dezash123/ring-pcb/models/BM03B-SRSS-TB.stp

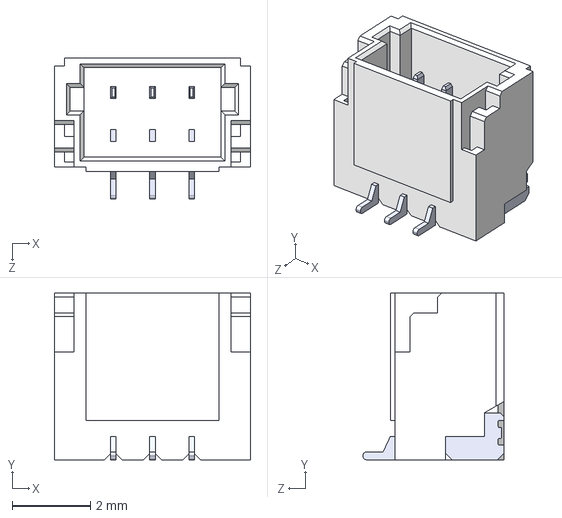
[picture p1: CAD file, 2025-11-14]
models/BM03B-SRSS-TB.stp
5.00 x 4.25 x 3.60 mm
