dezash123/ring-pcb/models/PG-LLGA-5-4_Z8B00190520_V03_3D.stp

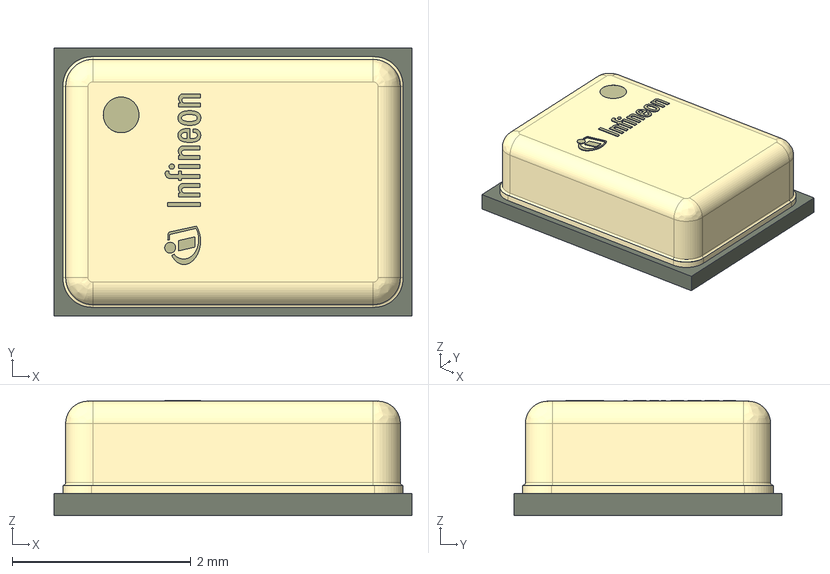
[picture p2: CAD file, 2025-11-14]
models/PG-LLGA-5-4_Z8B00190520_V03_3D.stp
4.00 x 3.00 x 1.29 mm
