dezash123/ring-pcb/models/DQN0004A.stp

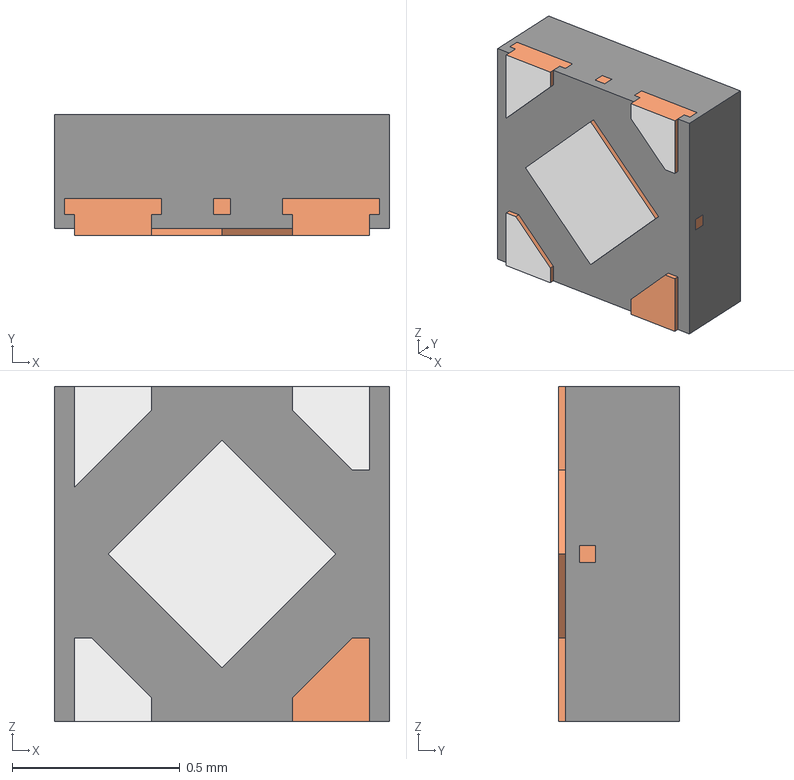
[picture p3: CAD file, 2025-11-14]
models/DQN0004A.stp
1.00 x 0.36 x 1.00 mm
MOLD-SNB04A
FRAME-SNB04A
