dezash123/ring-pcb/models/MAX30102EFD_T.stp

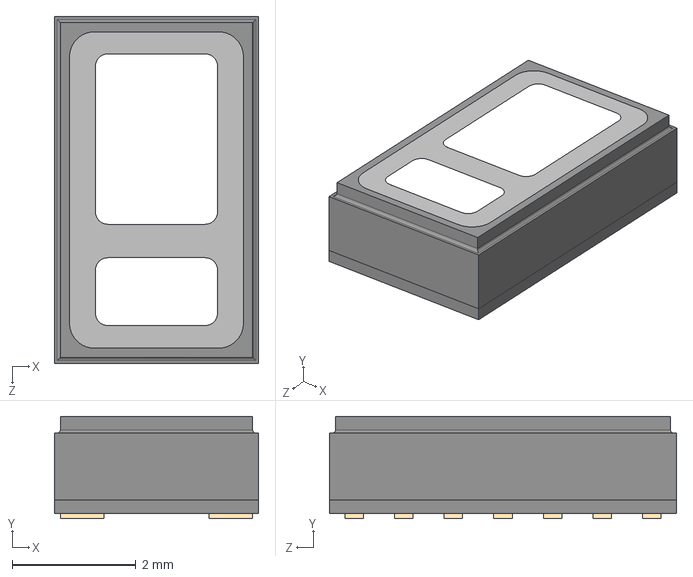
[picture p4: CAD file, 2025-11-14]
models/MAX30102EFD_T.stp
3.30 x 1.65 x 5.60 mm
