dezash123/ring-pcb/layout/layout-rounded.kicad_pcb

## KiCad design layout/layout-rounded.kicad_pcb (2025-10-16)

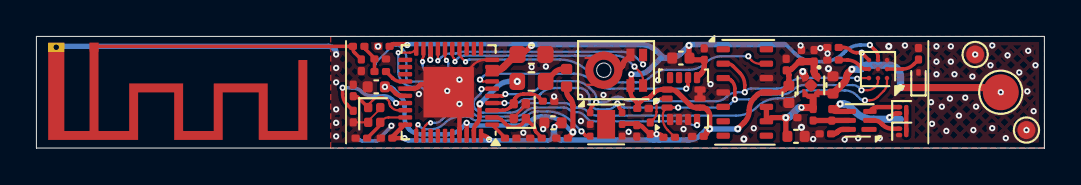
[picture p5: board layout-rounded.kicad_pcb from above]

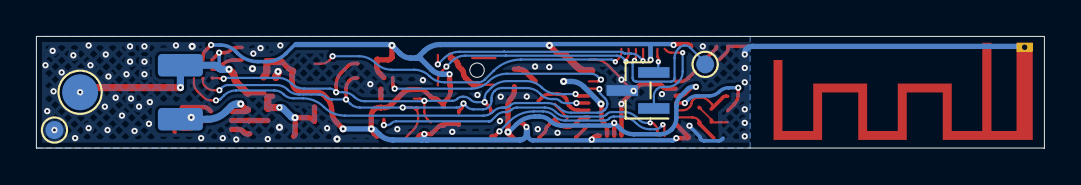
[picture p6: board layout-rounded.kicad_pcb from below]

Board: 2 copper layers, 56.0 x 6.2 mm, 60 parts (5 on the bottom side), 36 nets.

Parts:
BT1: ?; Battery
C1, C28, C29: 1uF; C_0201_0603Metric
C2: 2.2uF; C_0201_0603Metric
C3, C7, C8, C12, C19, C21, C22, C23, C25, C26: 100nF; C_0201_0603Metric
C4, C9: 5pF; C_0201_0603Metric
C5: 4.7uF; C_0603_1608Metric
C6, C14, C24, C27: 1uF; C_0402_1005Metric
C10, C11: 12pF; C_0201_0603Metric
C13: 100pF; C_0201_0603Metric
C15: 47nF; C_0201_0603Metric
C16: 1pF; C_0201_0603Metric
C17: 1.2pF; C_0201_0603Metric
C18: 10uF; C_0402_1005Metric
C20: 4.7uF; C_0402_1005Metric
D1: ESD9B5.0ST5G; D_SOD-923
J1: ?; Texas_SWRA117D_2.4GHz_Left
L1: 10uH; L_0603_1608Metric
L2: 15nH; L_0402_1005Metric
L3: 4.7nH; L_0201_0603Metric
L4: 2.2nH; L_0201_0603Metric
MK1: IM72D128V01; Infineon_PG-LLGA-5-1
Q1, Q2: CSD13380F3T; Texas_PicoStar_DFN-3_0.69x0.60mm
R1, R2: 4.7k; R_0201_0603Metric
R3: 10k; R_0201_0603Metric
R4: 2.2k; R_0201_0603Metric
R5: 330; R_0201_0603Metric
TP1, TP3, TP4, TP6: TestPoint_Pad_D1.0mm
TP2, TP5: TestPoint_Pad_D2.0mm
U1: BQ27427YZFR; BGA-9_1.6x1.6mm_Layout3x3_P0.5mm
U2: BQ29700; WSON-6_1.5x1.5mm_P0.5mm
U3: nRF52833-QDAA; Modified_QFN-40_5.0mmx5.0mm
U4: MAX30102EFD+T; Maxim_OLGA-14_3.3x5.6mm_P0.8mm
U5: LSM6DSOX; LGA-14_3x2.5mm_P0.5mm_LayoutBorder3x4y
U6: ?; PinHeader_1x03_P1.00mm_Vertical_SMD_Pin1Left
U7: TMP117AIDRVR; WSON-6-1EP_2x2mm_P0.65mm_EP1x1.6mm
U8: TPS7A2018PDQN; Texas_X2SON-4_1x1mm_P0.65mm
Y1: 8J32076001; Crystal_SMD_1210-4Pin_1.2x1.0mm
Y2: 3110M4-32.768DTTLLLL; Crystal_SMD_1210-4Pin_1.2x1.0mm

Connections:
GND: C1.2, C2.2, C4.2, C5.2, C6.2, C7.2, C8.2, C9.2, C10.2, C11.2, C12.2, C13.2, C14.2, C15.2, C16.2, C17.2, C18.2, C19.2, C20.2, C21.2, C22.2, C23.2, C24.2, C25.2, C26.2, C27.2, C28.2, C29.2, D1.2, J1.2, MK1.4, MK1.5, Q2.2, R3.2, R4.2, TP3.1, TP4.1, TP6.1, U1.B2, U1.C1, U3.10, U3.25, U3.37, U3.41, U4.4, U4.12, U5.1, U5.2, U5.3, U5.6, U5.7, U6.2, U7.2, U7.4, U8.2, U8.5, Y1.2, Y1.4, Y2.2, Y2.4
VBATT: BT1.1, C1.1, C18.1, C19.1, C27.1, D1.1, R5.1, TP2.1, TP5.1, U1.C3, U4.9, U4.10, U8.3, U8.4
VDD: C5.1, C6.1, C7.1, C8.1, C20.1, C21.1, C22.1, C23.1, C24.1, C25.1, C26.1, C28.1, C29.1, MK1.2, R1.1, R2.1, U1.C2, U3.8, U3.9, U3.18, U3.30, U3.40, U4.11, U5.5, U5.8, U5.12, U7.5, U8.1
bat_low: U1.A1, U3.6
batman.batman_vdd_out: C2.1, U1.B3
batman.bin: R3.1, U1.B1
battery.bat2: C3.1, R5.2, U2.5
battery.bat_cout: Q2.1, U2.2
battery.bat_dout: Q1.1, U2.3
battery.bat_qm: Q1.3, Q2.3
battery.bat_vm: R4.1, U2.6
battery.bat_vss: BT1.2, C3.2, Q1.2, U2.4
cpu.ant: L3.1, U3.24
cpu.antenna.n1: C16.1, L3.2, L4.1
cpu.antenna.n2: C17.1, J1.1, L4.2
cpu.dcc: L1.1, U3.39
cpu.dcc_mid: L1.2, L2.1
cpu.dec1: C12.1, U3.1
cpu.dec3: C13.1, U3.27
cpu.dec4_6: C14.1, C15.1, L2.2, U3.26, U3.38
cpu.xin: C4.1, U3.28, Y1.1
cpu.xl1: C10.1, U3.2, Y2.1
cpu.xl2: C11.1, U3.3, Y2.3
cpu.xout: C9.1, U3.29, Y1.3
hbt.NC: U4.1, U4.5, U4.6, U4.7, U4.8, U4.14
hbt_int: U3.14, U4.13
imu_int1: U3.32, U5.4
imu_int2: U3.7, U5.9
mic_clk: MK1.3, U3.17
mic_data: MK1.1, U3.15
rst: TP1.1, U3.16
scl: R2.2, U1.A3, U3.5, U4.2, U5.13, U7.1
sda: R1.2, U1.A2, U3.4, U4.3, U5.14, U7.6
swdclk: U3.20, U6.1
swdio: U3.19, U6.3
tmp_int: U3.31, U7.3
