dezash123/ring-pcb/(commit log)

2025-09-09 schematic basically done
    [ring.kicad_pcb, ring.kicad_sch]
2025-09-10 battery protection
    [ring.kicad_pcb, ring.kicad_sch]
2025-09-11 switched to smaller battery, will be removing external protection
    [ring.kicad_pcb, ring.kicad_sch]
2025-09-14 pcb laid out, schematic done
    [ring.kicad_pcb, ring.kicad_sch]
2025-09-18 nearly done routing
    [ring.kicad_pcb, ring.kicad_sch]
2025-09-20 moving to using zener
    [layout.kicad_pcb]
2025-09-21 added in rf power
    [layout.kicad_pcb]
2025-09-21 finished port and antenna in zener
    [layout.kicad_pcb]
2025-09-21 laid out pcb and began routing (6.2mm tall!)
    [layout.kicad_pcb]
2025-09-21 board fully routed; fixing DRC
    [layout.kicad_pcb]
2025-09-21 pretty rounded tracks; breaks everything though
    [layout.kicad_pcb]
2025-09-23 drc passes
    [layout.kicad_pcb]
2025-09-27 replaced mcu, removed old connections in layout
    [layout.kicad_pcb]
2025-09-28 nrf laid out but unrouted; probably have to switch for manufacturing
    [layout.kicad_pcb]
2025-09-28 init esp32h2
2025-09-28 layout and custom footprint for clearance
    [layout.kicad_pcb]
2025-09-29 reounded done
    [layout-rounded.kicad_pcb]
2025-09-29 add mpns
    [layout-rounded.kicad_pcb]
2025-09-30 all mpns
    [layout.kicad_pcb]
2025-10-03 more vias
    [layout-rounded.kicad_pcb, layout.kicad_pcb]
2025-10-03 two-sided port
    [layout-rounded.kicad_pcb, layout.kicad_pcb]
2025-10-05 change port spacing
    [layout-rounded.kicad_pcb, layout.kicad_pcb]
2025-10-12 changed connector
    [layout.kicad_pcb]
2025-10-12 update rounded board
    [layout-rounded.kicad_pcb]
2025-10-12 added crystal mpns and updated caps
    [layout-rounded.kicad_pcb, layout.kicad_pcb]
2025-10-13 dock updates
    [layout.kicad_pcb]
2025-10-14 change to 3.3V
2025-10-15 stricter DRC
    [layout-rounded.kicad_pcb, layout.kicad_pcb]
2025-10-16 stricterer DRC
    [layout-rounded.kicad_pcb, layout.kicad_pcb]
2025-11-14 more reorganization
    [BM03B-SRSS-TB.stp, DQN0004A.stp, MAX30102EFD_T.stp, PG-LLGA-5-4_Z8B00190520_V03_3D.stp, layout-rounded.kicad_pcb, layout.kicad_pcb]
